eSpark-Backup/awad-shibli-wireless-sensor-network/README.md

# AwadShibli-WirelessSensorNetwork

Project Scope:
 
This project involves the end-to-end development of a wireless sensor network (WSN) using LoRa technology to monitor key environmental parameters such as temperature, humidity, and air quality. The system will include multiple distributed sensor nodes communicating wirelessly with a centralized base station, providing real-time data acquisition and visualization.
 
⸻
 
1. Research & Development (R&D) Deliverables
• 1.1 Technology Review Report:
• Detailed overview of LoRa communication protocol and its advantages for low-power, long-range applications.
• Summary of relevant sensors (temperature, humidity, air quality) and microcontrollers suitable for integration with LoRa modules.
• 1.2 Requirements Specification:
• Defined functional requirements including sampling rate, communication range, and accuracy.
• Non-functional requirements such as low power consumption, environmental robustness, and data integrity.
• 1.3 Component Selection Report:
• Justification for selected sensors, microcontrollers (e.g., STM32, ATmega), LoRa modules (e.g., SX1276), and power sources (battery, solar).
• Datasheets and comparison tables.
 
⸻
 
2. System Design Deliverables
• 2.1 System Architecture Diagram:
• Overview showing distributed sensor nodes, LoRa links, and the central LoRa gateway or base station.
• 2.2 Hardware Design Documents:
• Schematic diagrams and PCB layouts for sensor nodes and base station interface.
• BOM (Bill of Materials) with part numbers and sources.
• 2.3 Software Design Documents:
• Firmware architecture for sensor data acquisition and LoRa transmission.
• Base station software for packet reception, decoding, and data logging.
• Data structure and communication protocol definitions.
 
⸻
 
3. Prototype Development Deliverables
• 3.1 Functional Sensor Nodes (minimum 3 units):
• Each node equipped with LoRa transceiver, environmental sensors, and battery power.
• Integrated and tested for accurate sensing and reliable LoRa communication.
• 3.2 Base Station Implementation:
• Receives data via LoRa and displays/stores it locally.
• Optional GUI or command-line interface for monitoring.
• 3.3 Enclosure and Mounting Designs:
• Optional 3D-printed or off-the-shelf weatherproof housings for field deployment.
 
⸻
 
4. Testing and Validation Deliverables
• 4.1 Functional Verification:
• End-to-end validation of sensor readings, data transmission, and base station reception.
• 4.2 Range Testing:
• Measurement of maximum reliable communication range in both open and obstructed environments.
• 4.3 Data Integrity and Reliability Testing:
• Packet loss rate, latency, and error rate evaluation.
• 4.4 Sensor Calibration Report:
• Calibration results and comparison to commercial-grade instruments.
 
⸻
 
5. Final Documentation Deliverables
• 5.1 Technical Report:
• Comprehensive documentation of the entire system including R&D, design, implementation, and testing.
• 5.2 User Guide:
• Step-by-step instructions for deploying and operating the WSN system.
• 5.3 Source Code and Design Files:
• Fully commented source code for firmware and base station.
• All schematics, PCB files, and mechanical design files.
• 5.4 Project Presentation Slides:
• Visual summary for stakeholders, including objectives, system overview, results, and future improvements.
 
⸻
 
6. Optional Deliverables
• 6.1 Data Logging to Cloud Platform:
• Integration with platforms such as ThingSpeak or AWS IoT for remote monitoring and data analysis.
• 6.2 Power Optimization Report:
• Sleep modes, duty cycling, and solar charging implementation for extended deployment.
• 6.3 Scalable Network Design:
• Outline for expanding the node count or integrating additional environmental parameters.
