eSpark-Backup/awad-shibli-wireless-sensor-network/docs/Scheme/Project_Scheme_End-Device.pdf

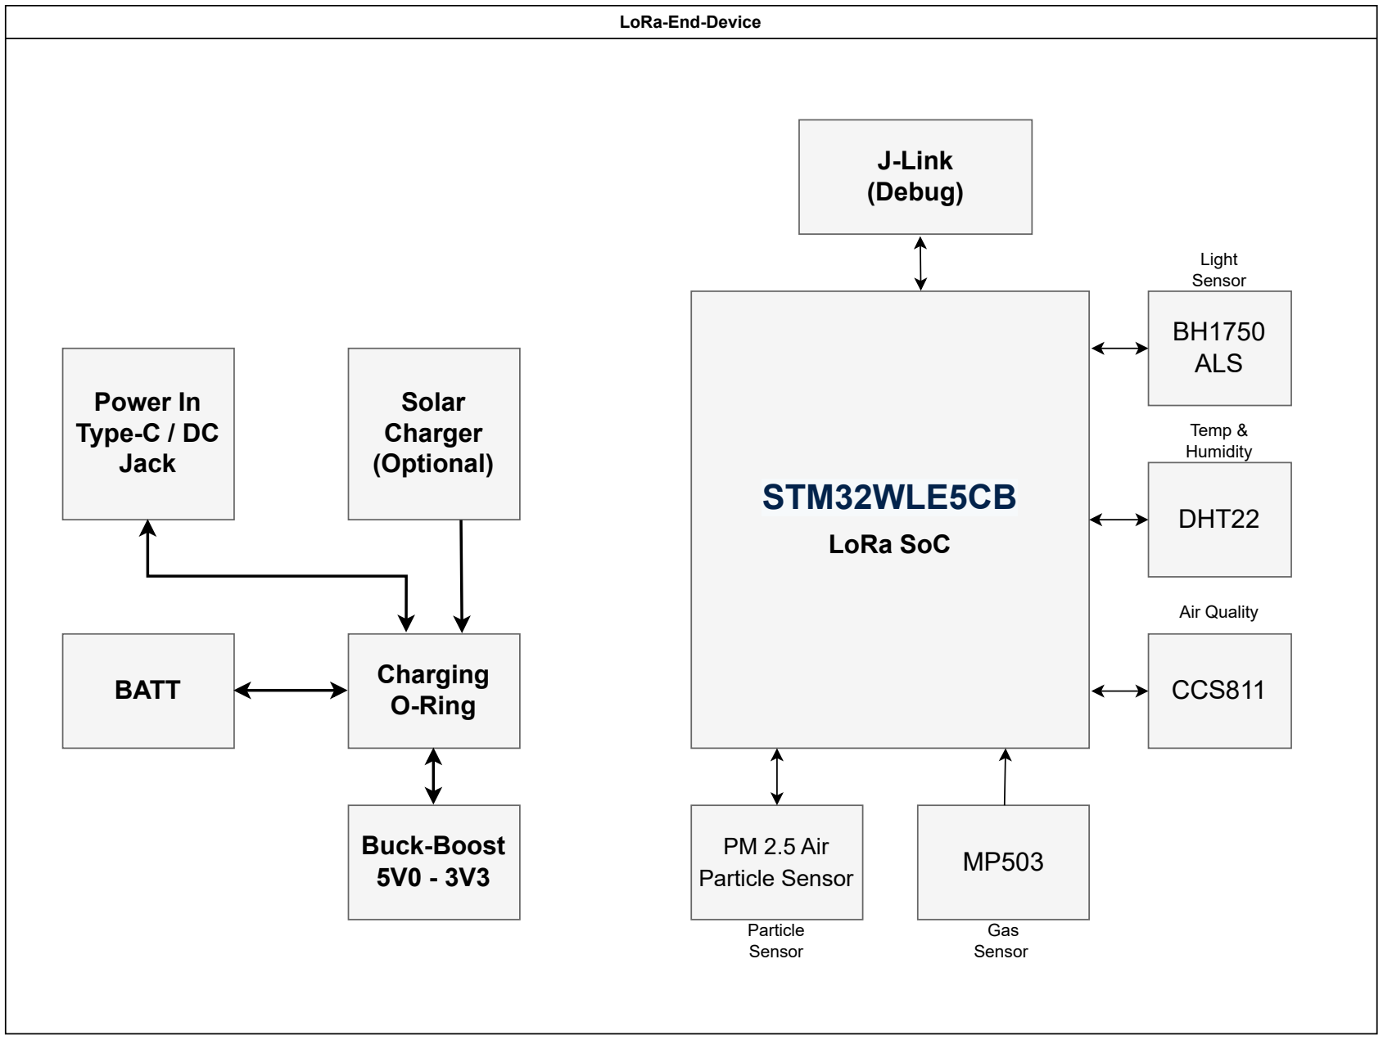
[picture p2: figure]
STM32WLE5CB; LoRa SoC; Buck-Boost 5V0 - 3V3; PM 2.5 Air Particle Sensor; J-Link (Debug); CCS811; Charging O-Ring BATT; DHT22; Power In Type-C / DC Jack; BH1750 ALS; Light Sensor; Temp & Humidity; Air Quality; Particle Sensor; Gas Sensor; Solar Charger (Optional); LoRa-End-Device
