eSpark-Backup/awad-shibli-wireless-sensor-network/Design-Files/End-Device-v1.0/Deliverables/_Renderings/2D_SecondLayer_View.png

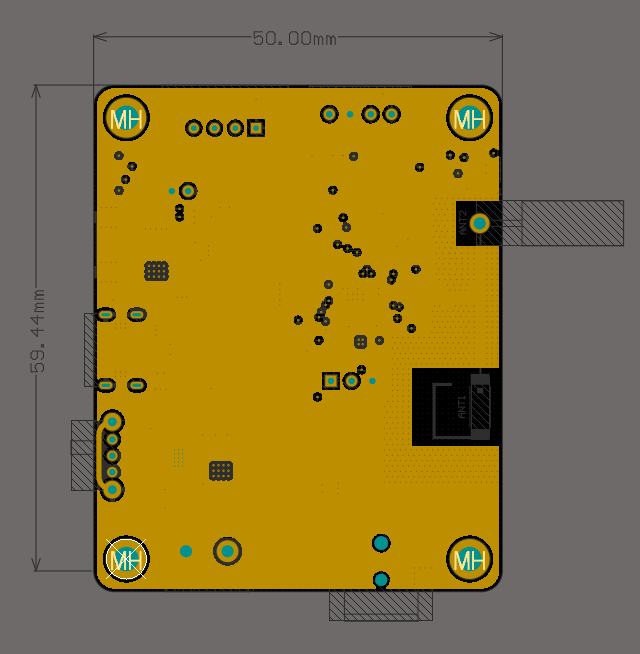
Design-Files/End-Device-v1.0/Deliverables/_Renderings/2D_SecondLayer_View.png
