eSpark-Backup/awad-shibli-wireless-sensor-network/Design-Files/Gateway-Device-v1.0/Deliverables/_Renderings/2D_ThirdLayer_View.png

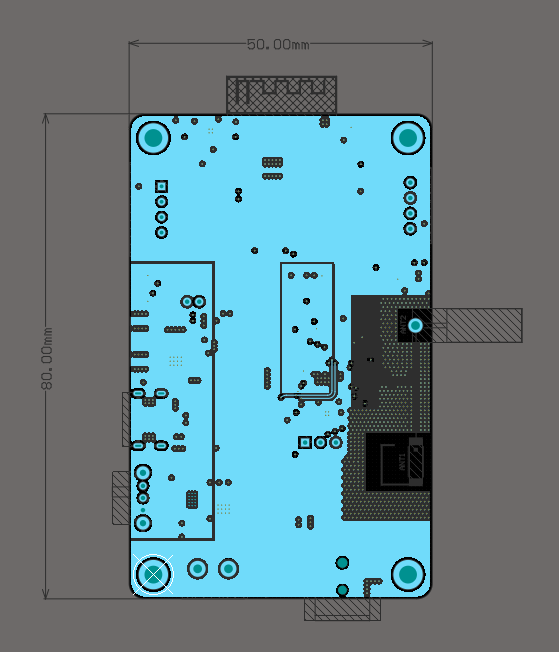
Design-Files/Gateway-Device-v1.0/Deliverables/_Renderings/2D_ThirdLayer_View.png
