eSpark-Backup/awad-shibli-wireless-sensor-network/Design-Files/End-Device-v1.0/Deliverables/BOM/Client BOM of End-Device-v1.0.xlsx

# | Item Type | Designator | Description | Footprint | Manufacturer Part Number | Manufacturer | Value | Quantity | Remarks
1 | RF Antennas | ANT1 | RF ANT 915MHZ CHIP SOLDER SMD | Custom | 0915AT43A0026001E | Johanson | - | 1
2 | Antenna | ANT2 | 1.8 Helical Antenna Vertical 915MHz 50W Antennas ROHS | Custom | VG915SNX17-5W2 | Vollgo | - | 1
3 | Capacitors | C1, C3, C12 | CAP CER 10UF 25V X7R 0805 | Cap-0805 | GRM21BZ71E106KE15L | Murata | 10uF | 3
4 | Capacitors | C2, C4, C11, C17, C21, C22, C25, C28, C40, C41, C47, C48, C49, C50 | CAP CER 0.1UF 25V X7R 0402 | Cap-0402 | CC0402KRX7R8BB104 | Yageo | 0.1uF | 14
5 | Capacitor | C5, C10 | CAP CER 4700PF 1KV X7R 1206 | Cap-1206 | CC1206KKX7RCBB472 | Yageo | 4.7nF | 2
6 | Capacitor | C6 | CAP CER 22UF 10V X7R 0805 | Cap-0805 | GRM21BZ71A226ME15L | Murata | 22uF | 1
7 | Capacitor | C7, C8, C9 | CAP CER 10UF 10V X7R 0603 | Cap-0603 | GRM188Z71A106KA73D | Murata | 10uF | 3
8 | Capacitor | C16, C24, C27 | CAP CER 4.7UF 16V X5R 0402 | Cap-0402 | CL05A475MO5NUNC | Samsung | 4.7uF | 3
9 | Capacitors | C18, C23, C33, C34 | CAP CER 33PF 50V C0G/NP0 0402 | Cap-0402 | GJM1555C1H330GB01D | Murata | 33pF | 4
10 | Capacitor | C19, C20 | CAP CER 6.8PF 50V C0G/NPO 0402 | Cap-0402 | CC0402CRNPO9BN6R8 | Yageo | 6.8pF | 2
11 | Capacitors | C29 | CAP CER 0.47UF 50V X5R 0402 | Cap-0402 | GRM155R61H474KE11D | Murata | 470nF | 1
12 | Capacitor | C30 | CAP CER 0.047UF 50V X7R 0402 | Cap-0402 | CC0402KRX7R9BB473 | Yageo | 47nF | 1
13 | Capacitors | C31 | CAP CER 68PF 50V C0G/NPO 0402 | Cap-0402 | CC0402FRNPO9BN680 | Yageo | 68pF | 1
14 | Capacitor | C32, C38 | CAP CER 2.2PF 50V C0G/NP0 0402 | Cap-0402 | GRM1555C1H2R2BA01D | Murata | 2.2pF | 2
15 | Capacitors | C35 | CAP CER 10000PF 50V X7R 0402 | Cap-0402 | GRM155R71H103KA88D | Murata | 10nF | 1
16 | Capacitors | C36 | CAP CER 0.7PF 50V C0G/NP0 0402 | IND-0402 | GJM1555C1HR70BB01D | Murata | 0.7pF | 1
17 | Capacitors | C37 | CAP CER 7.5PF 50V C0G/NP0 0402 | Cap-0402 | GJM1555C1H7R5BB01D | Murata | 7.5pF | 1
18 | Capacitors | C39 | CAP CER 4PF 50V C0G/NP0 0402 | Cap-0402 | GJM1555C1H4R0BB01D | Murata | 4pF | 1
19 | Capacitors | C42 | CAP CER 47PF 50V C0G/NP0 0402 | Cap-0402 | GCM1555C1H470FA16D | Murata | 47pF | 1
20 | Capacitor | C43 | CAP CER 10PF 50V C0G/NP0 0402 | Cap-0402 | GRM1555C1H100JA01D | Murata | 10pF | 1
21 | Capacitors | C46 | CAP CER 4.3PF 50V C0G/NP0 0402 | Cap-0402 | GJM1555C1H4R3BB01D | Murata | 4.3pF | 1
22 | TVS Diodes | D1 | 9.5V 400W 7.5V 5V WSON-6(2x2) ESD and Surge Protection (TVS/ESD) ROHS | WSON-6(2x2) | TVS0500DRVR | Texas Instruments | - | 1
23 | Diode | D2 | Independent 5W 18V SMB Zener Diodes ROHS | SMB_ | SMBJ5355B-MS | MSKSEMI | - | 1
24 | ESD Diode | D3 | 1 Surface Mount WSON-6(2x2) Surge Protection Devices (SPDs) ROHS | WSON-6(2x2) | TVS1800DRVR | Texas Instruments | - | 1
25 | Diode | D4, D5, D6 | 40V 500mV@2A 2A SMA(DO-214AC) Schottky Barrier Diodes (SBD) ROHS | SMA | SS24A | Guangdong Hottech | - | 3
26 | Diode | D7 | TVS DIODE 3VWM ST0201 | Diode-0201 | ESDALC6V1-1U2 | STMicroelectronics | - | 1
27 | Fuse | F1 | 24V 750mA 100A 1.5A 1210 Resettable Fuses ROHS | FUSE-1210 | 1210L075/24PR | Littlefuse | - | 1
28 | Ferrite Bead | FB1 | 500mΩ ±25% 600Ω@100MHz 0603 Ferrite Beads ROHS | IND-0603 (1608 Metric) | FCM1608KF-601T03 | Tai Tech | - | 1
29 | Ferrite Beads | FB2 | FERRITE BEAD 1 KOHM 0402 1LN | IND-0402 | BLM15HG102SN1D | Murata | - | 1
30 | Connector | J1 | Receptacle USB - Type C 6 - USB Connectors ROHS | Custom | Type-C-31-M-17 | Koren Hroparts Elec | - | 1
31 | Connectors | J2 | CONN HEADER SMD R/A 2POS 2MM | Custom | S2B-PH-SM4-TB(LF)(SN) | JST | - | 1
32 | Terminal Block | J3 | 1x2P 18A -40℃~+105℃ 250V Green 12~30 Straight 5.08mm 2.5 1 2 Plugin,P=5.08mm Screw terminal ROHS | Custom | DB128L-5.08-2P-GN-S | DORABO | - | 1
33 | DC Jack | J4 | Surface Mount DC Power Receptacle -20℃~+70℃ 2mm 6.4mm 2A 30V SMD AC/DC Power Connectors ROHS | Custom | DC-050-B200 | XUNPU | - | 1
34 | Male Header | J5 | Gold 250V 3A Straight Square Pins 2.5mm 3P 260℃ 6mm -40℃~+105℃ 3mm 2.54mm Plugin Black Brass 1x3P Plugin,P=2.54mm Pin Headers ROHS | HDR1X3_ | X6511WV-03H-C60D30 | XKB | - | 1
35 | Male Header | J7 | Gold 250V 1A Brick nogging Square Pins 1mm 10P 260℃ 4mm -40℃~+105℃ 1.27mm 双排 Black Brass 2x5P SMD,P=1.27mm Pin Headers ROHS | Custom | X1321WVS-2x05J-C40D53 | XKB Connectivity | - | 1
36 | Inductor | L1 | FIXED IND 1UH 3.2A 0.042OHM SMD | IND-1008 (2520 Metric) | DFE252012P-1R0M=P2 | Murata | 1uH | 1
37 | Fixed Inductors | L2 | FIXED IND 15UH 250MA 950MOHM SMD | IND-0805 | MLZ2012M150WT000 | TDK | 15uH | 1
38 | Fixed Inductors | L3 | FIXED IND 47NH 210MA 1.08OHM SMD | IND-0402 | LQW15AN47NG00D | Murata | 47nH | 1
39 | Fixed Inductors | L4 | FIXED IND 3.3NH 900MA 0.04OHM SM | IND-0402 | LQW15AN3N3D10D | Murata | 3.3nH | 1
40 | Fixed Inductors | L5 | FIXED IND 8.2NH 540MA 0.14OHM SM | IND-0402 | LQW15AN8N2G00D | Murata | 8.2nH | 1
41 | Fixed Inductors | L6 | FIXED IND 9.1NH 1.4A 0.08OHM SMD | IND-0402 | LQW15AN9N1G8ZD | Murata | 9.1nH | 1
42 | LED | LED1 | RED LED 0603 Light Emitting Diodes | LED-0603 | NCD0603R3 | Foshan NationStar Optoelectronics | - | 1
43 | LED | LED2 | Emerald 0603 Light Emitting Diodes (LED) ROHS | LED-0603 | NCD0603G2 | Foshan NationStar Optoelectronics | - | 1
44 | NTC Thermistors | NTC1 | 10kΩ 50mW ±1% NTC Thermistors ROHS | Custom | MF51B 103F3435 | Nanjing Shiheng Elec | 10K | 1
45 | MOSFET | Q1 | MOSFET P-CH 30V 4.3A SOT23-3 | SOT-23 | AOSS21311C | Alpha & Omega Semiconductor | - | 1
46 | Mosfet | Q2 | Trans Mosfet P-ch 30V 4A 3-PIN SOT-23 T/r | SOT-23 | AO3401A | Alpha & Omega Semiconductor | - | 1
47 | Resistor | R1, R3 | RES 5.1K OHM 1% 1/16W 0402 | Res-0402 | RC0402FR-075K1L | Yageo | 5.1K | 2
48 | Resistors | R2, R4, R36 | RES 220 OHM 1% 1/16W 0402 | Res-0402 | RC0402FR-07220RL | Yageo | 220R | 3
49 | Resistor | R5 | RES SMD 21.5KOHM 0.1% 1/16W 0402 | Res-0402 | RT0402BRD0721K5L | Yageo | 21.5K | 1
50 | Resistor | R6, R9 | RES SMD 1M OHM 1% 1/10W 0603 | Res-0603 | RC0603FR-071ML | Yageo | 1M | 2
51 | Resistor | R7 | RES SMD 6.98KOHM 0.1% 1/16W 0402 | Res-0402 | RT0402BRD076K98L | Yageo | 6.98K | 1
52 | Resistors | R8 | RES SMD 649 OHM 0.1% 1/16W 0402 | Res-0402 | RT0402BRD07649RL | Yageo | 649R | 1
53 | Resistor | R10, R44 | RES SMD 10 OHM 1% 1/10W 0603 | Res-0603 | RC0603FR-0710RL | Yageo | 10R | 2
54 | Resistor | R11 | RES 47K OHM 1% 1/16W 0402 | Res-0402 | RC0402FR-0747KL | Yageo | 47K | 1
55 | Resistors | R16, R17, R24, R29, R34, R35, R38, R39 | RES 0 OHM JUMPER 1/16W 0402 | Res-0402 | RC0402FR-070RL | Yageo | 0R | 8
56 | Resistor | R25 | RES 10K OHM 1% 1/16W 0402 | Res-0402 | RC0402FR-0710KL | Yageo | 10K | 1
57 | Resistor | R27, R28 | RES 0 OHM JUMPER 1/8W 0805 | Res-0805 | RC0805FR-070RL | Yageo | 0R | 2
58 | Resistor | R31 | RES 1K OHM 1% 1/20W 0201 | Res-0201 | RC0201FR-071KP | Yageo | 1K | 1
59 | Resistor | R32, R33, R41, R42 | RES 4.7K OHM 1% 1/16W 0402 | Res-0402 | RC0402FR-074K7L | Yageo | 4.7K | 4
60 | Resistor | R40, R43 | RES 1K OHM 1% 1/16W 0402 | Res-0402 | RC0402FR-071KL | Yageo | 1K | 2
61 | Slide Switch | SW1 | Lying 1A SPDT 9.6mm 8.6mm 24V 3.6mm Black PCPin 10000 Rectangular columnar -25℃~+70℃ Plugin Slide Switches ROHS | Custom | SK-12D29-G060 | G-Switch | - | 1
62 | Switch | SW4 | SWITCH TACTILE SPST-NO 0.05A 12V | Custom | B3U-1000P | Omron | - | 1
63 | IC | U1 | IC BATT CHG LI-ION 1CELL 10WSON | 10-WSON (3x2) | BQ24210DQCR | Texas Instruments | - | 1
64 | IC | U2 | IC REG BUCK BST 3.3V 3.5A 14VSON | 14-VSON (4x3) | TPS63021DSJR | Texas Instruments | - | 1
65 | IC | U3 | IC RF TXRX+MCU ISM<1GHZ 48UFQFPN | 48-UFQFPN(7x7) | STM32WLE5CBU6 | STMicroelectronics | - | 1
66 | IC | U5 | SENSOR OPT 560NM AMBIENT 6WSOF | 6-WSOF | BH1750FVI-TR | Rohm | - | 1
67 | Sensor | U6 | SIP-4 Temperature and Humidity Sensor ROHS | Custom | AM2302 | Aosong (Guangzhou) Elec | - | 1
68 | Sensor | U7 | SIP-4 Gas Sensors ROHS | Custom | AGS02MA | Aosong (Guangzhou) Elec | - | 1
69 | Crystal | X1 | CRYSTAL 32.7680KHZ 6PF SMD | Custom | NX3215SA-32.768K-STD-MUA-14 | NDK | 32.7680KHZ | 1
70 | Oscillators | X2 | XTAL OSC TCXO 32.0000MHZ CLPSNW | SMD2520-4P | ECS-TXO-25CSMV-320-DY-TR | ECS International | 32MHz | 1
71 | Crystal | X3 | CRYSTAL 32.0000MHZ 8PF SMD | SMD2520-4P | ECS-320-8-36B-CKY-TR | ECS International | 32MHz | 1
72 | Peripheral | Battery | 804050 2000mAh Battery 3.7V Li-Polymer Lithium Ion Batteries for Massager Medical Equipment Car Air Filter Loudspeaker | Custom | - | - | - | 1 | Aliexpress (https://vi.aliexpress.com/item/1005009196364640.html)
