eSpark-Backup/awad-shibli-wireless-sensor-network/Design-Files/End-Device-v1.0/Deliverables/_Supporting Files/End-Device-v1.0.step

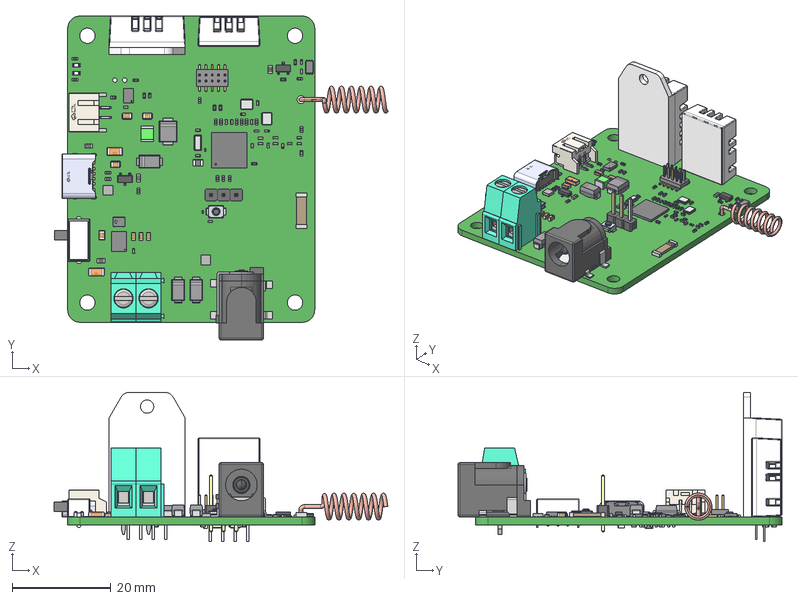
[picture p19: CAD file, 2025-07-15]
Design-Files/End-Device-v1.0/Deliverables/_Supporting Files/End-Device-v1.0.step
67.5 x 65.5 x 30.2 mm
User Library-Crystal NDK NX2520SA series x 2
User Library-RES_1005-0402 x 31
User Library-d0402h025 x 6
TPS7A2633DRVR x 2
User Library-DO-214AA SMB
User Library-Capacitor 0402 x 36
User Library-NDK_NX3215SA
UFQFPN-48_7X7X0P55MM
TPS63020DSJR--3DModel-STEP-1
User Library-OMRON B3U1000P
G-Switch SK-12D29-G060
User Library-RESC1608X05N x 4
User Library-0201(0603M) Res
User Library-CR2012-0805 x 2
CircuitWorks-SOT-23 x 2
User Library-LED SMD0603 x 2
VLS252012HBX-100M
User Library-RM127_10pin_Header
User Library-Header_Male_3Pin_PinArray
User Library-Header_Male_3Pin_BodyArray
DC-050-B200
SOLID.step
Lötende x 2
base
term1
term2
User Library-DO-214AC SMA x 3
User Library-0805 SMD Capacitor x 4
User Library-1206 SMD Capacitor x 2
User Library-CAPC1608X09 x 3
