eSpark-Backup/awad-shibli-wireless-sensor-network/(list of files, cad)

Other CAD files:
Design-Files/End-Device-v1.0/Deliverables/_Supporting Files/End-Device-v1.0..DXF
Design-Files/End-Device-v1.0/Deliverables/_Supporting Files/End-Device-v1.0.DWG
Design-Files/Gateway-Device-v1.0/Deliverables/_Supporting Files/Gateway-Device-v1.0..DWG
