eSpark-Backup/awad-shibli-wireless-sensor-network/Design-Files/End-Device-v1.0/Schematic/End-Device-v1.0.pdf

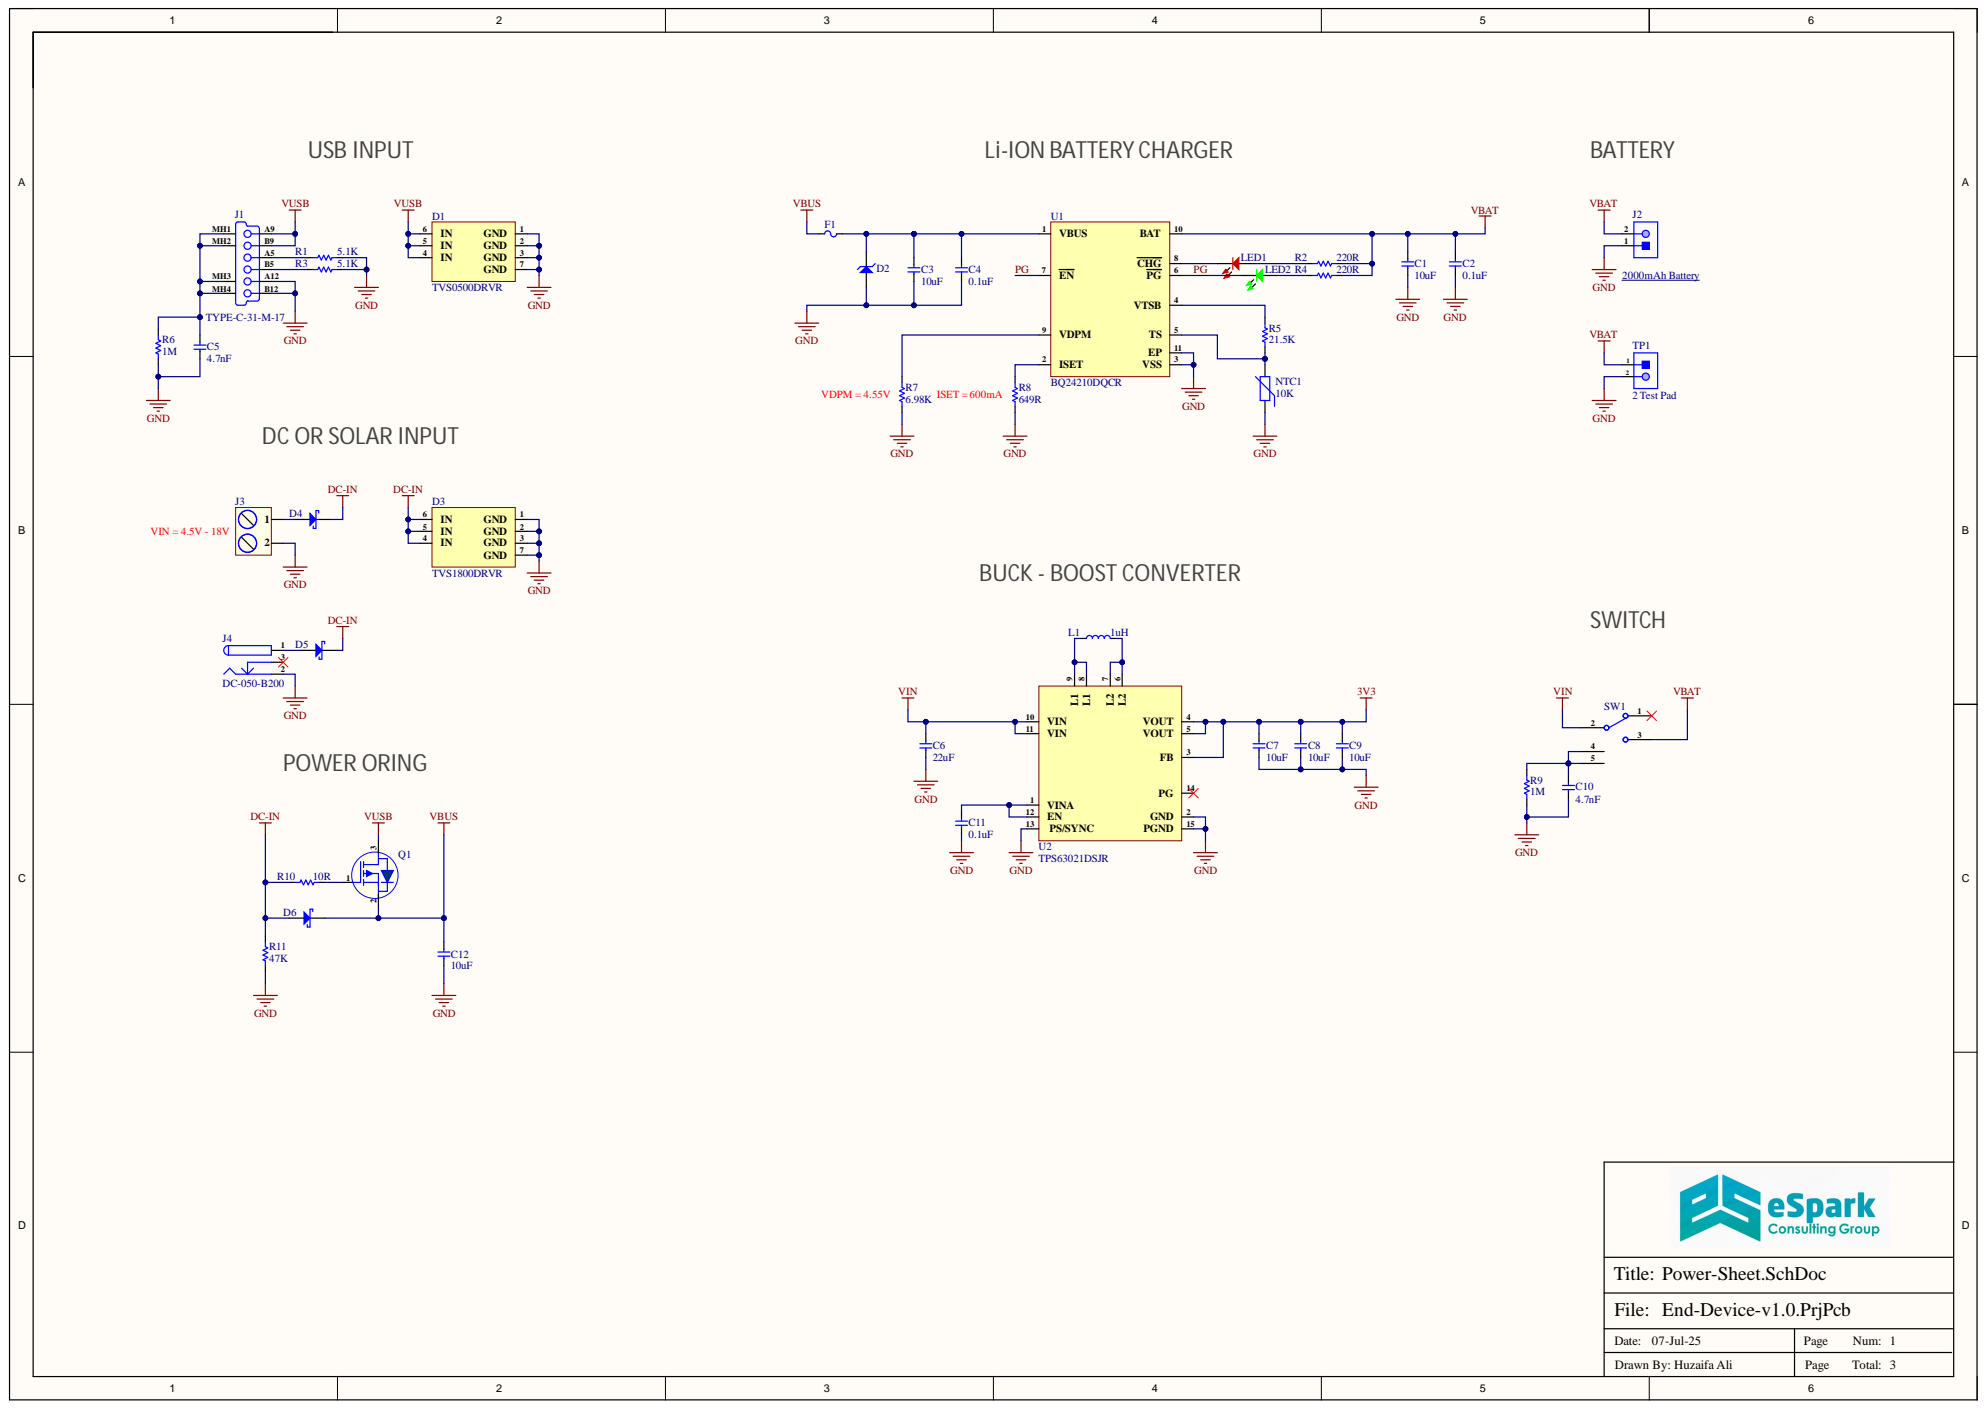
[picture p24: page 1]

Date : 0 7-Jul-2 5 | P a g e Nu m : 13

Drawn By: Hu z aifa Ali | P a g e T ota l :

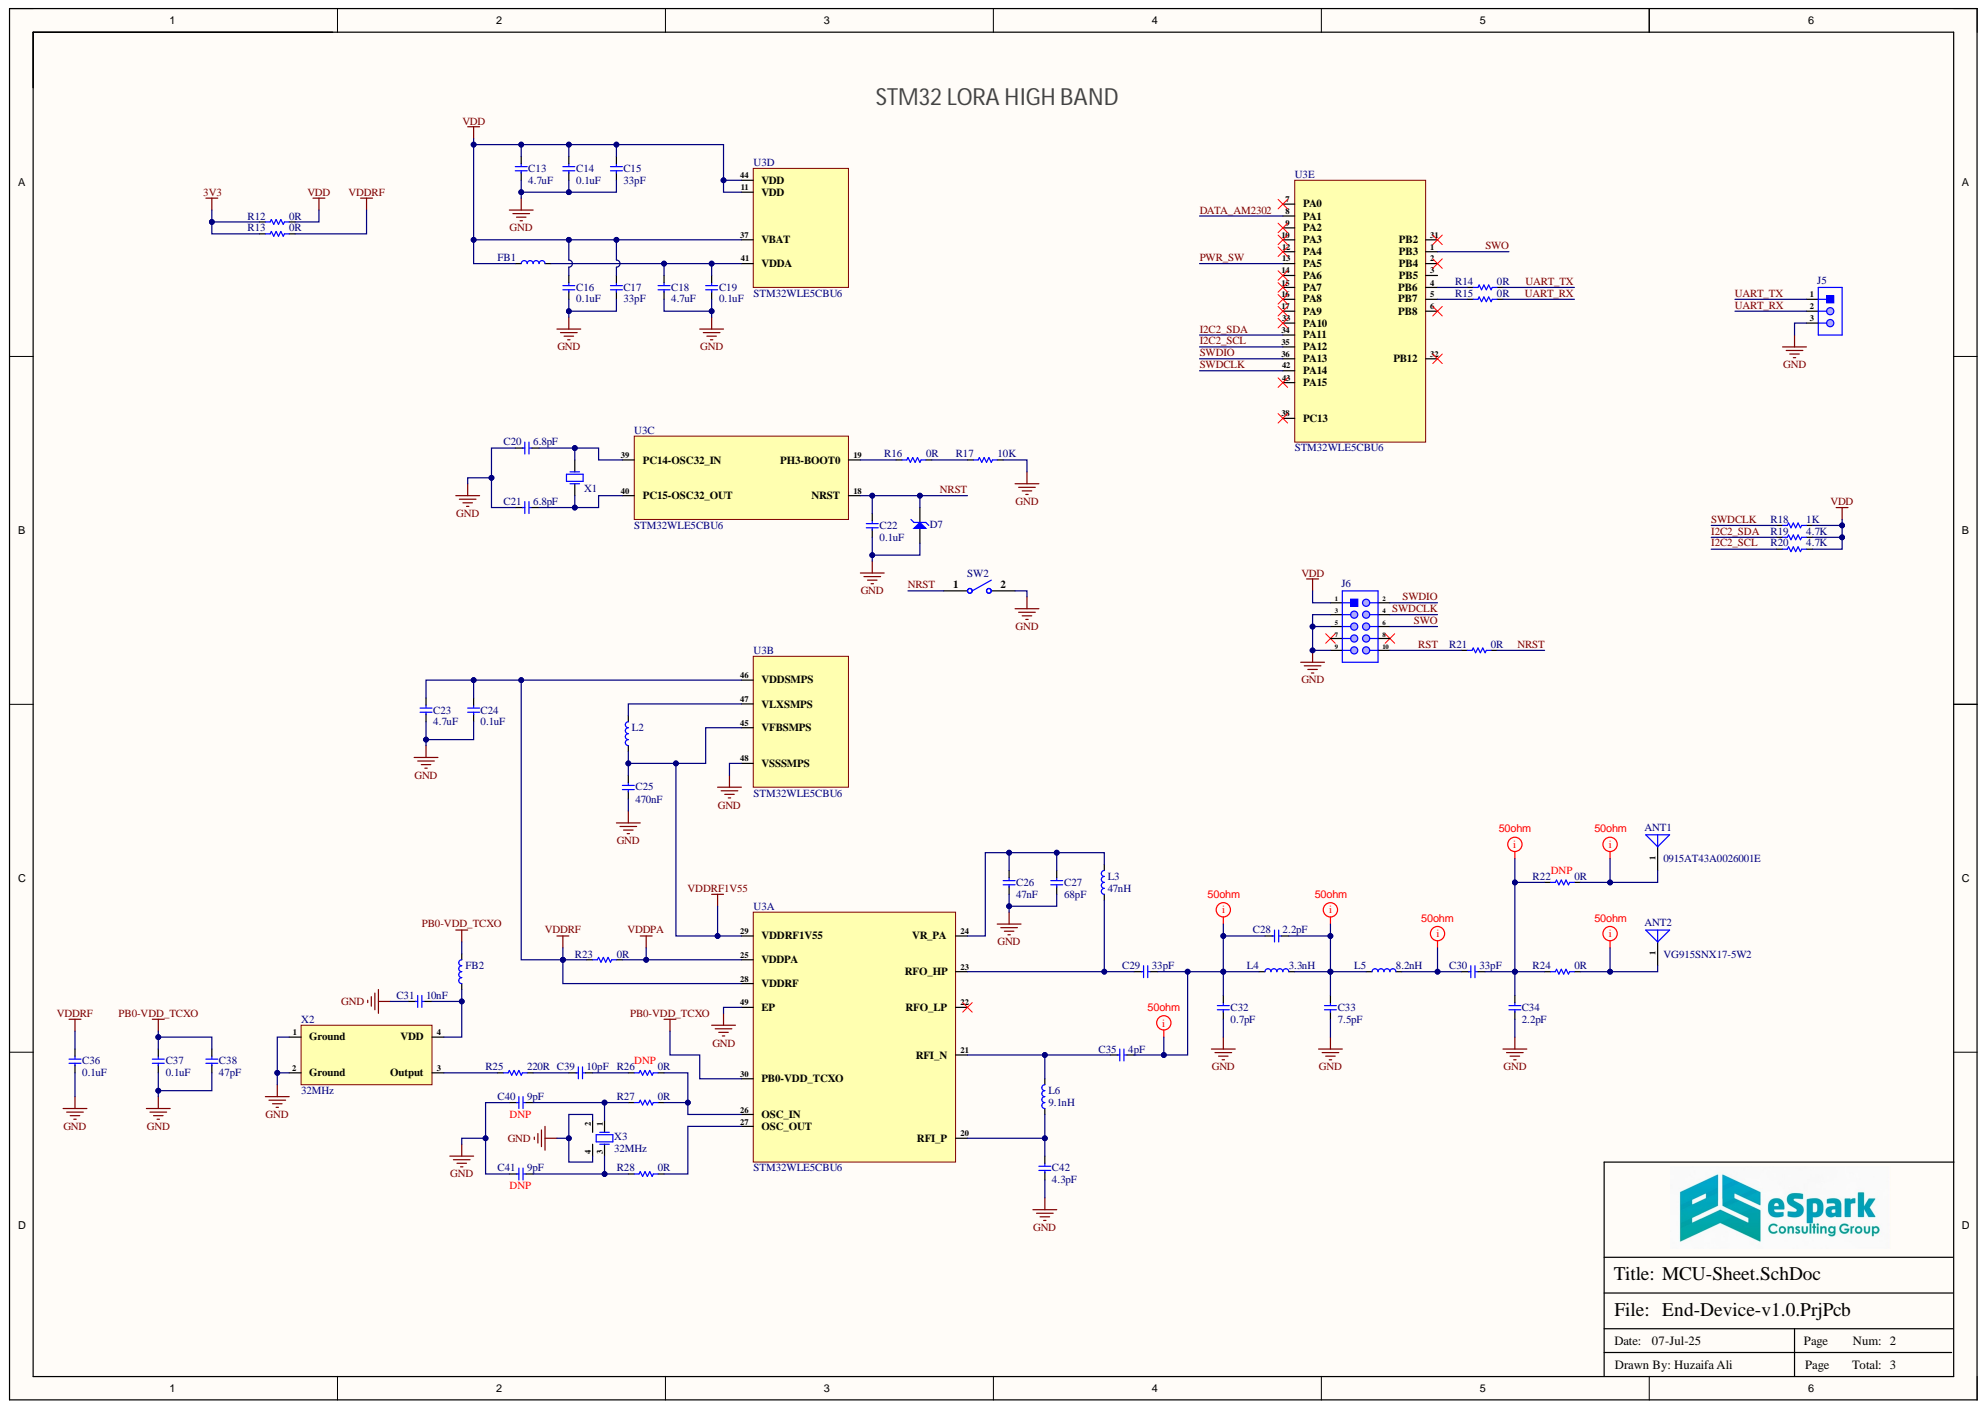
[picture p25: page 2]

Date: 07-Jul-25 | Page Num: 2

Drawn By: Huzaifa Ali | Page Total: 3

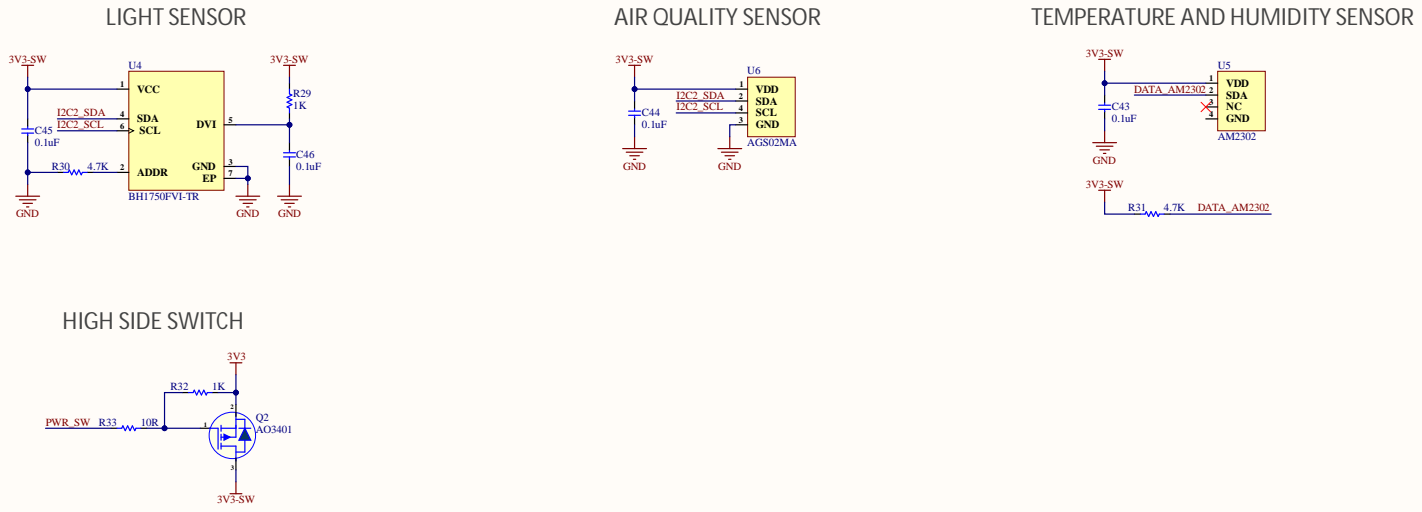
[picture p26: page 3]

Date : 0 7-Jul-2 5 | P a g e Nu m : 33

Drawn By: Hu z aifa Ali | P a g e T ota l :
