eSpark-Backup/awad-shibli-wireless-sensor-network/Design-Files/End-Device-v1.0/Deliverables/_Schematics/End-Device-v1.0.pdf

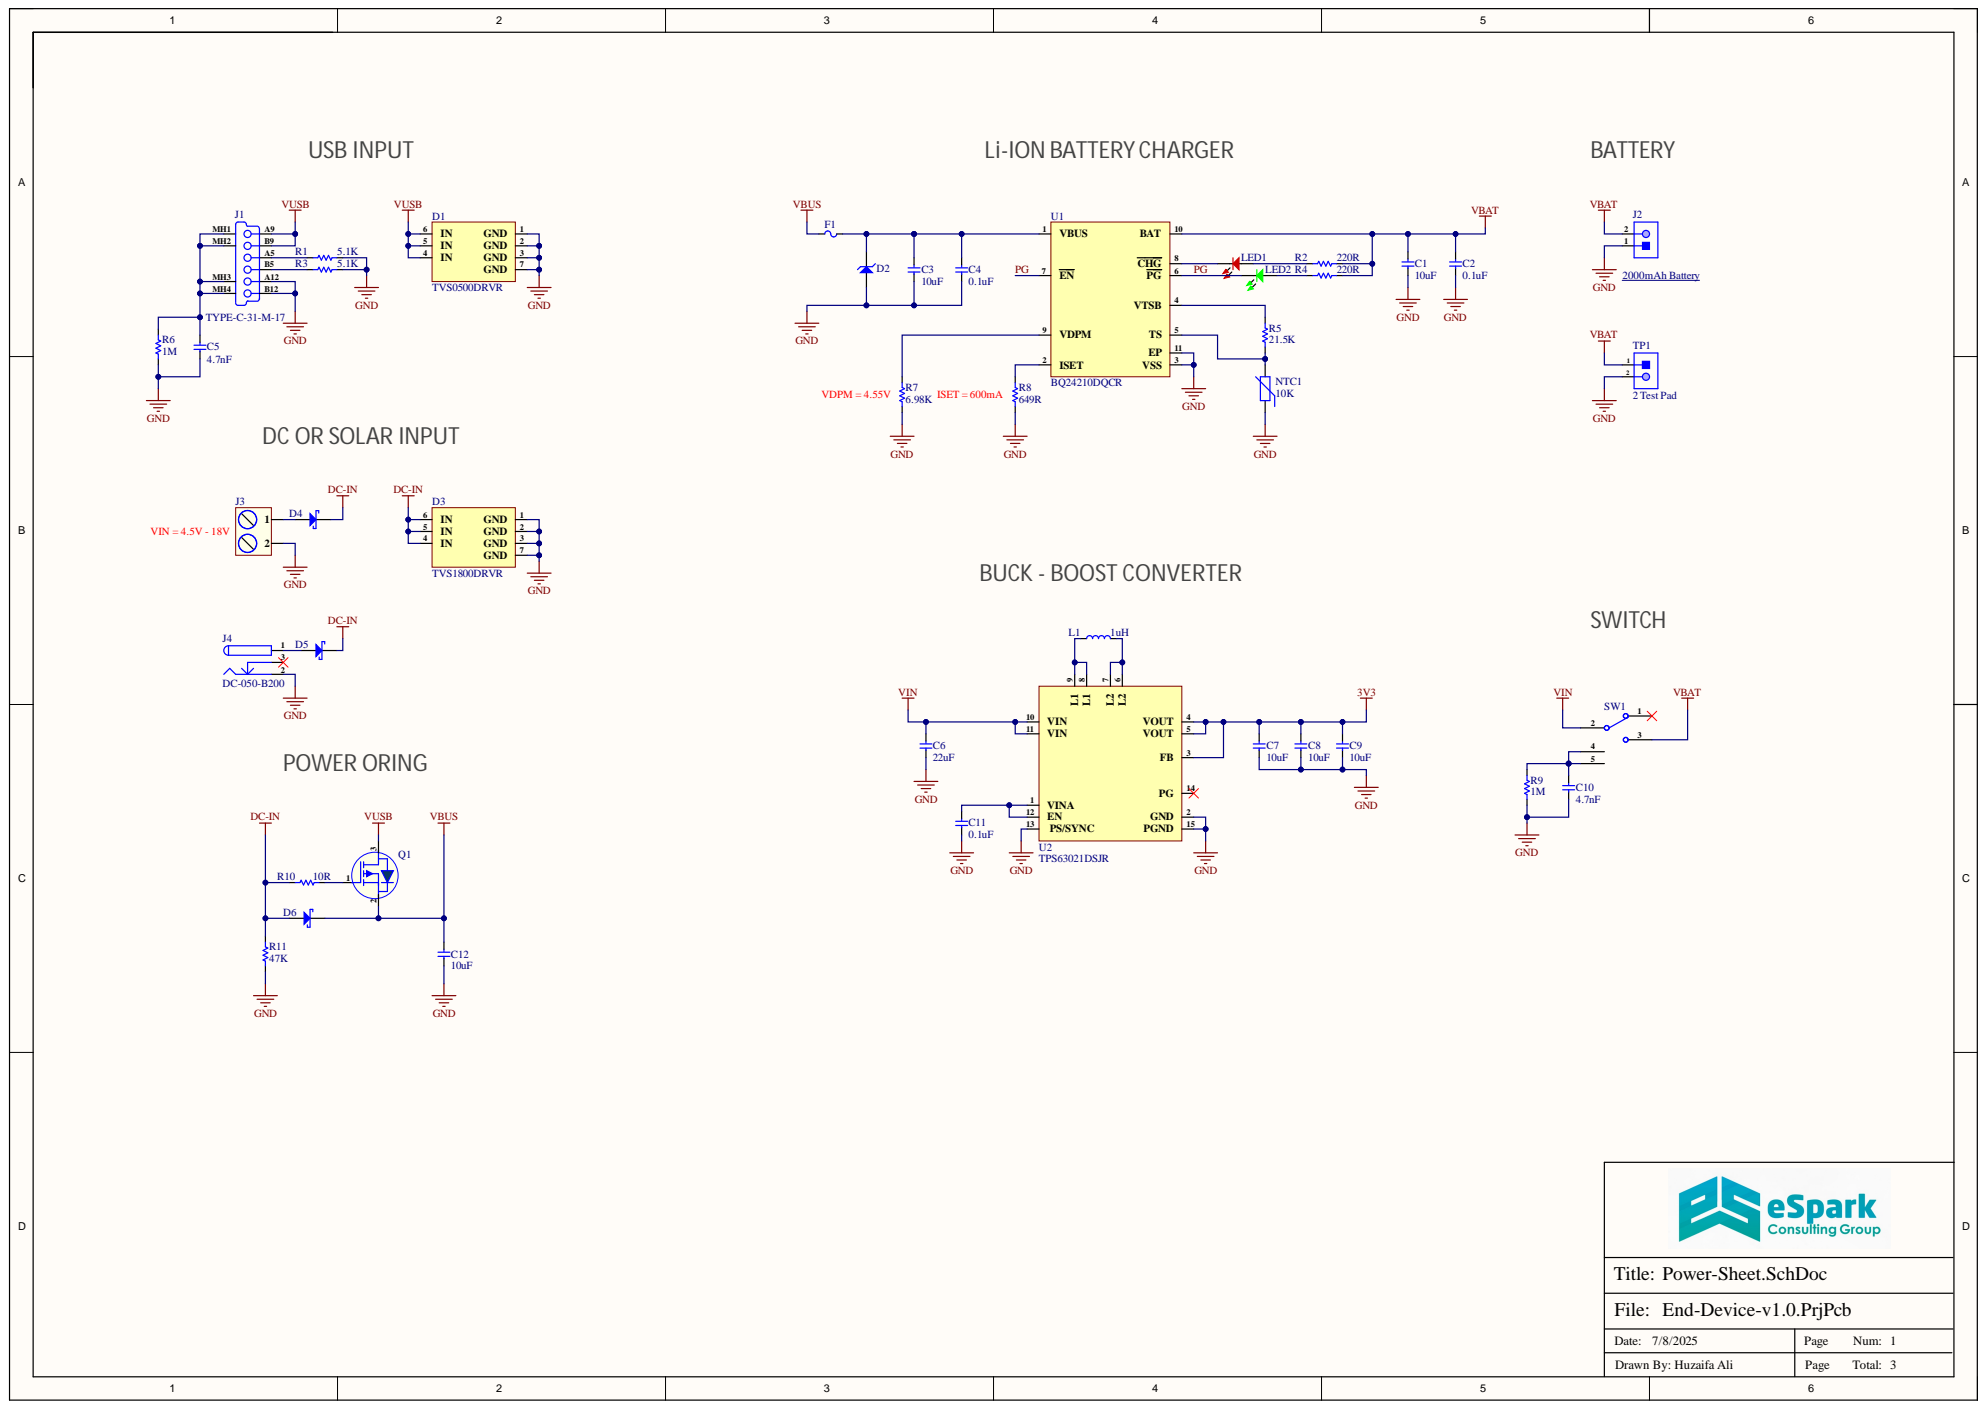
[picture p31: page 1]

Date : 7/8/2 0 2 5 | P a g e Nu m : 13

Drawn By: Hu z aifa Ali | P a g e T ota l :

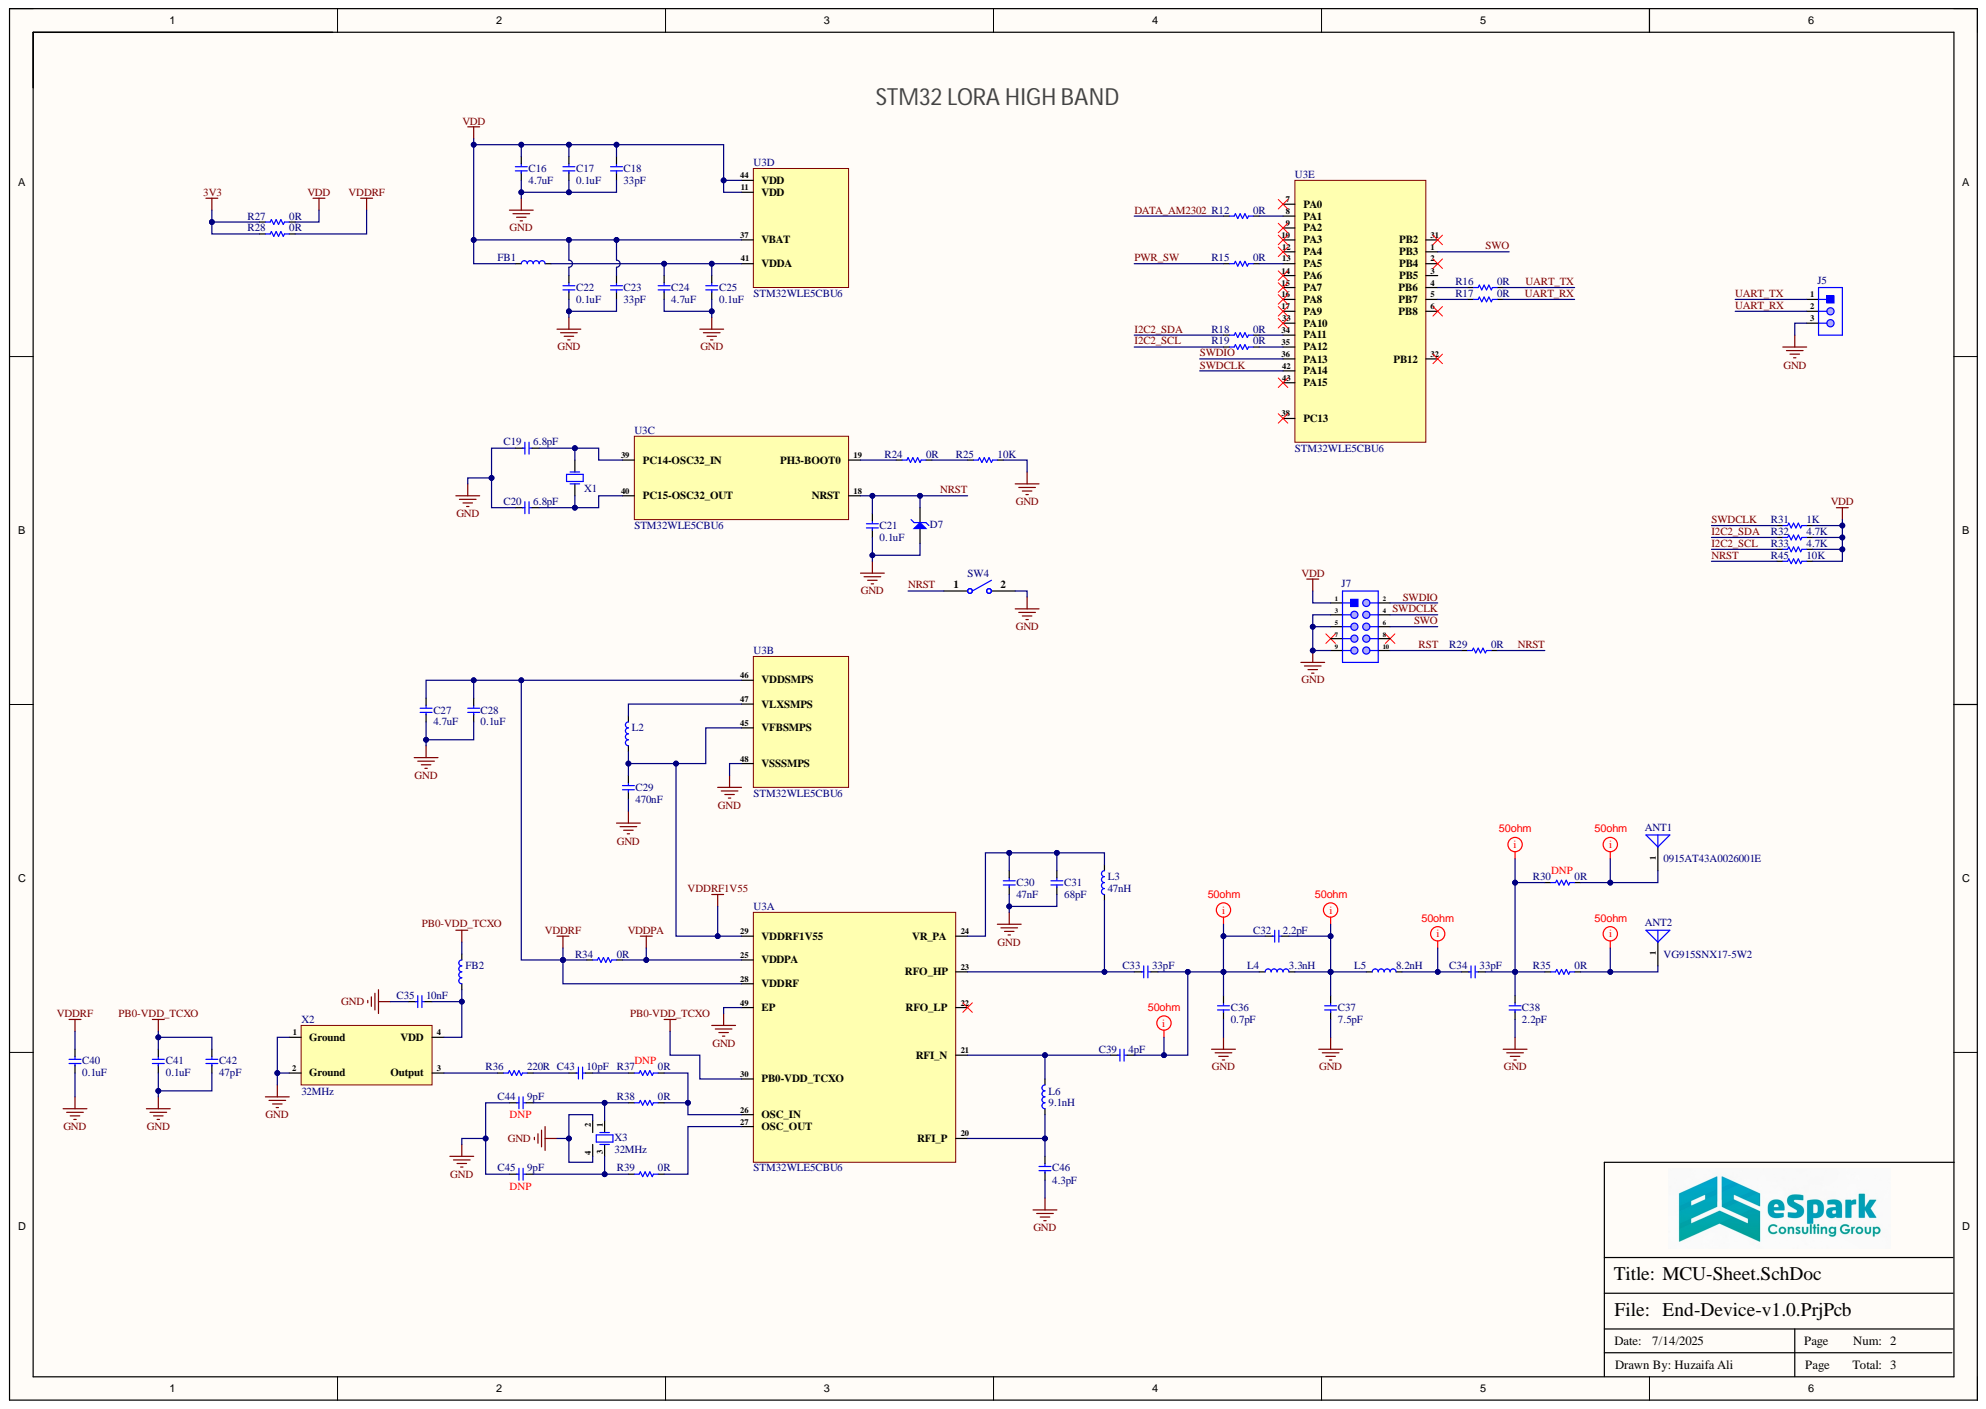
[picture p32: page 2]

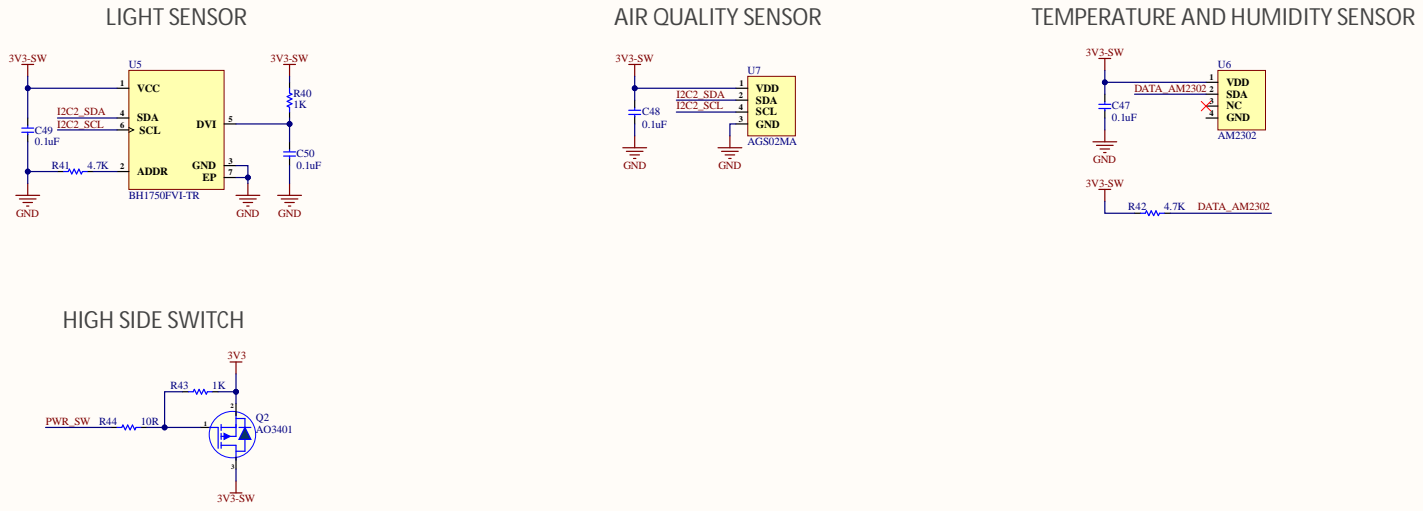
[picture p33: page 3]

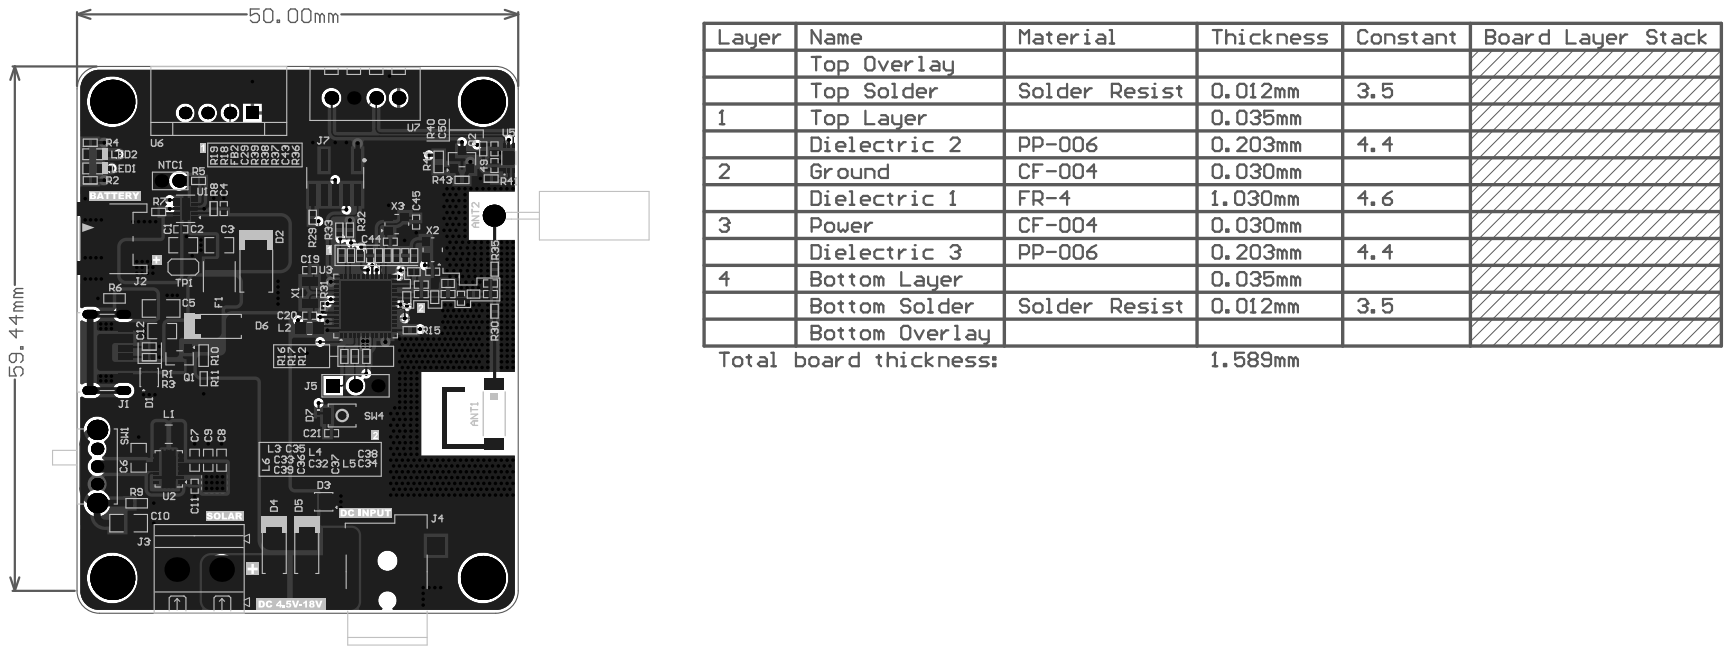
[picture p34: page 4]
