eSpark-Backup/awad-shibli-wireless-sensor-network/Design-Files/Gateway-Device-v1.0/Deliverables/_Schematics/Gateway-Device-v1.0.pdf

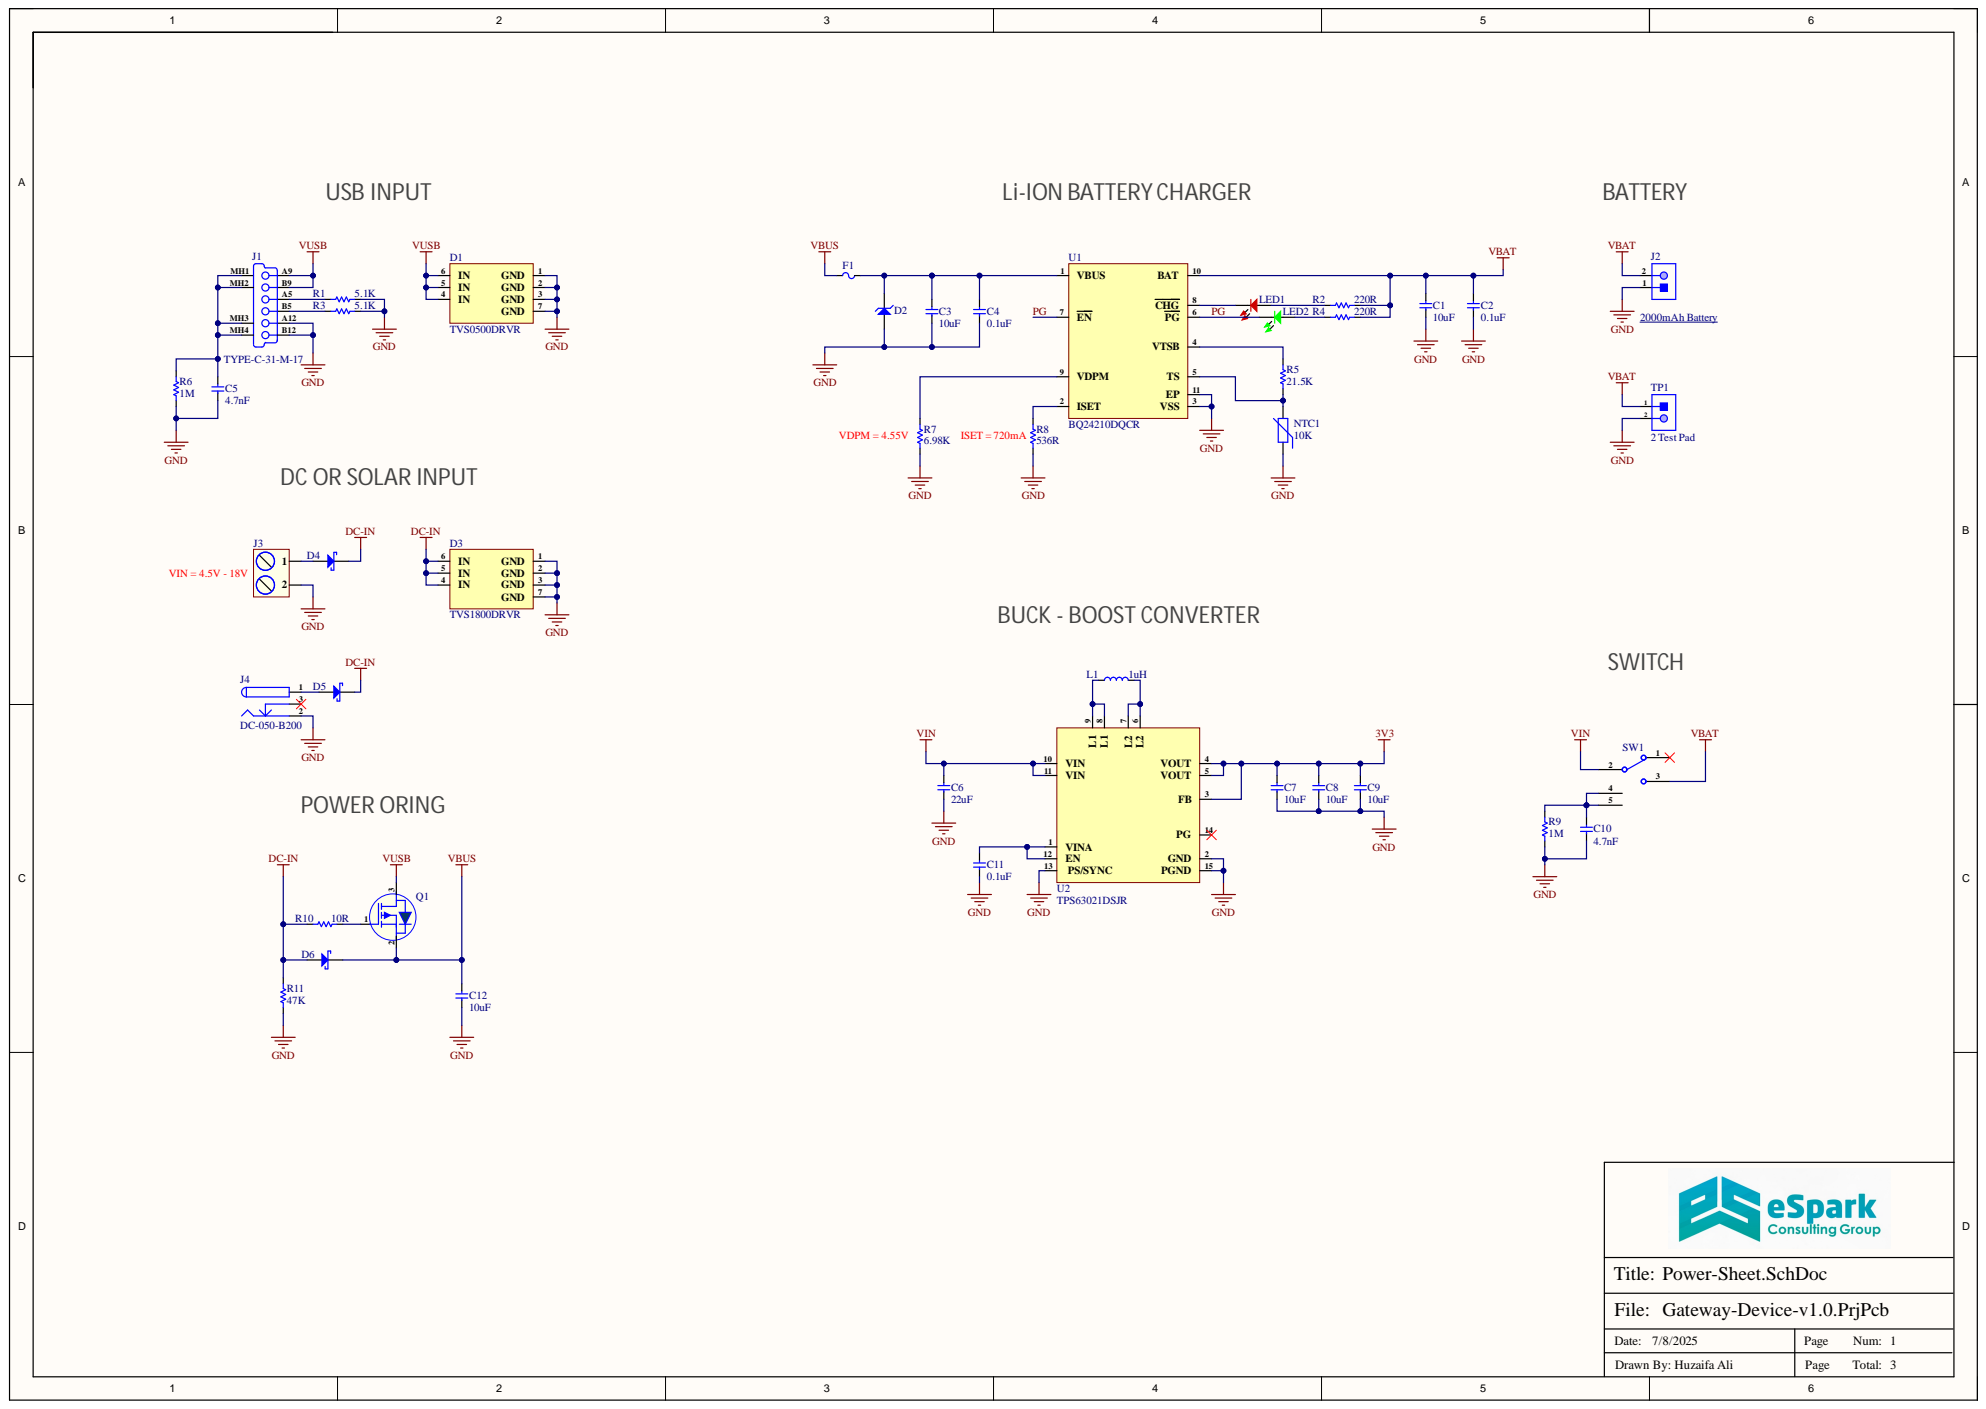
[picture p39: page 1]

Date : 7/8/2 0 2 5 | P a g e Nu m : 13

Drawn By: Hu z aifa Ali | P a g e T ota l :

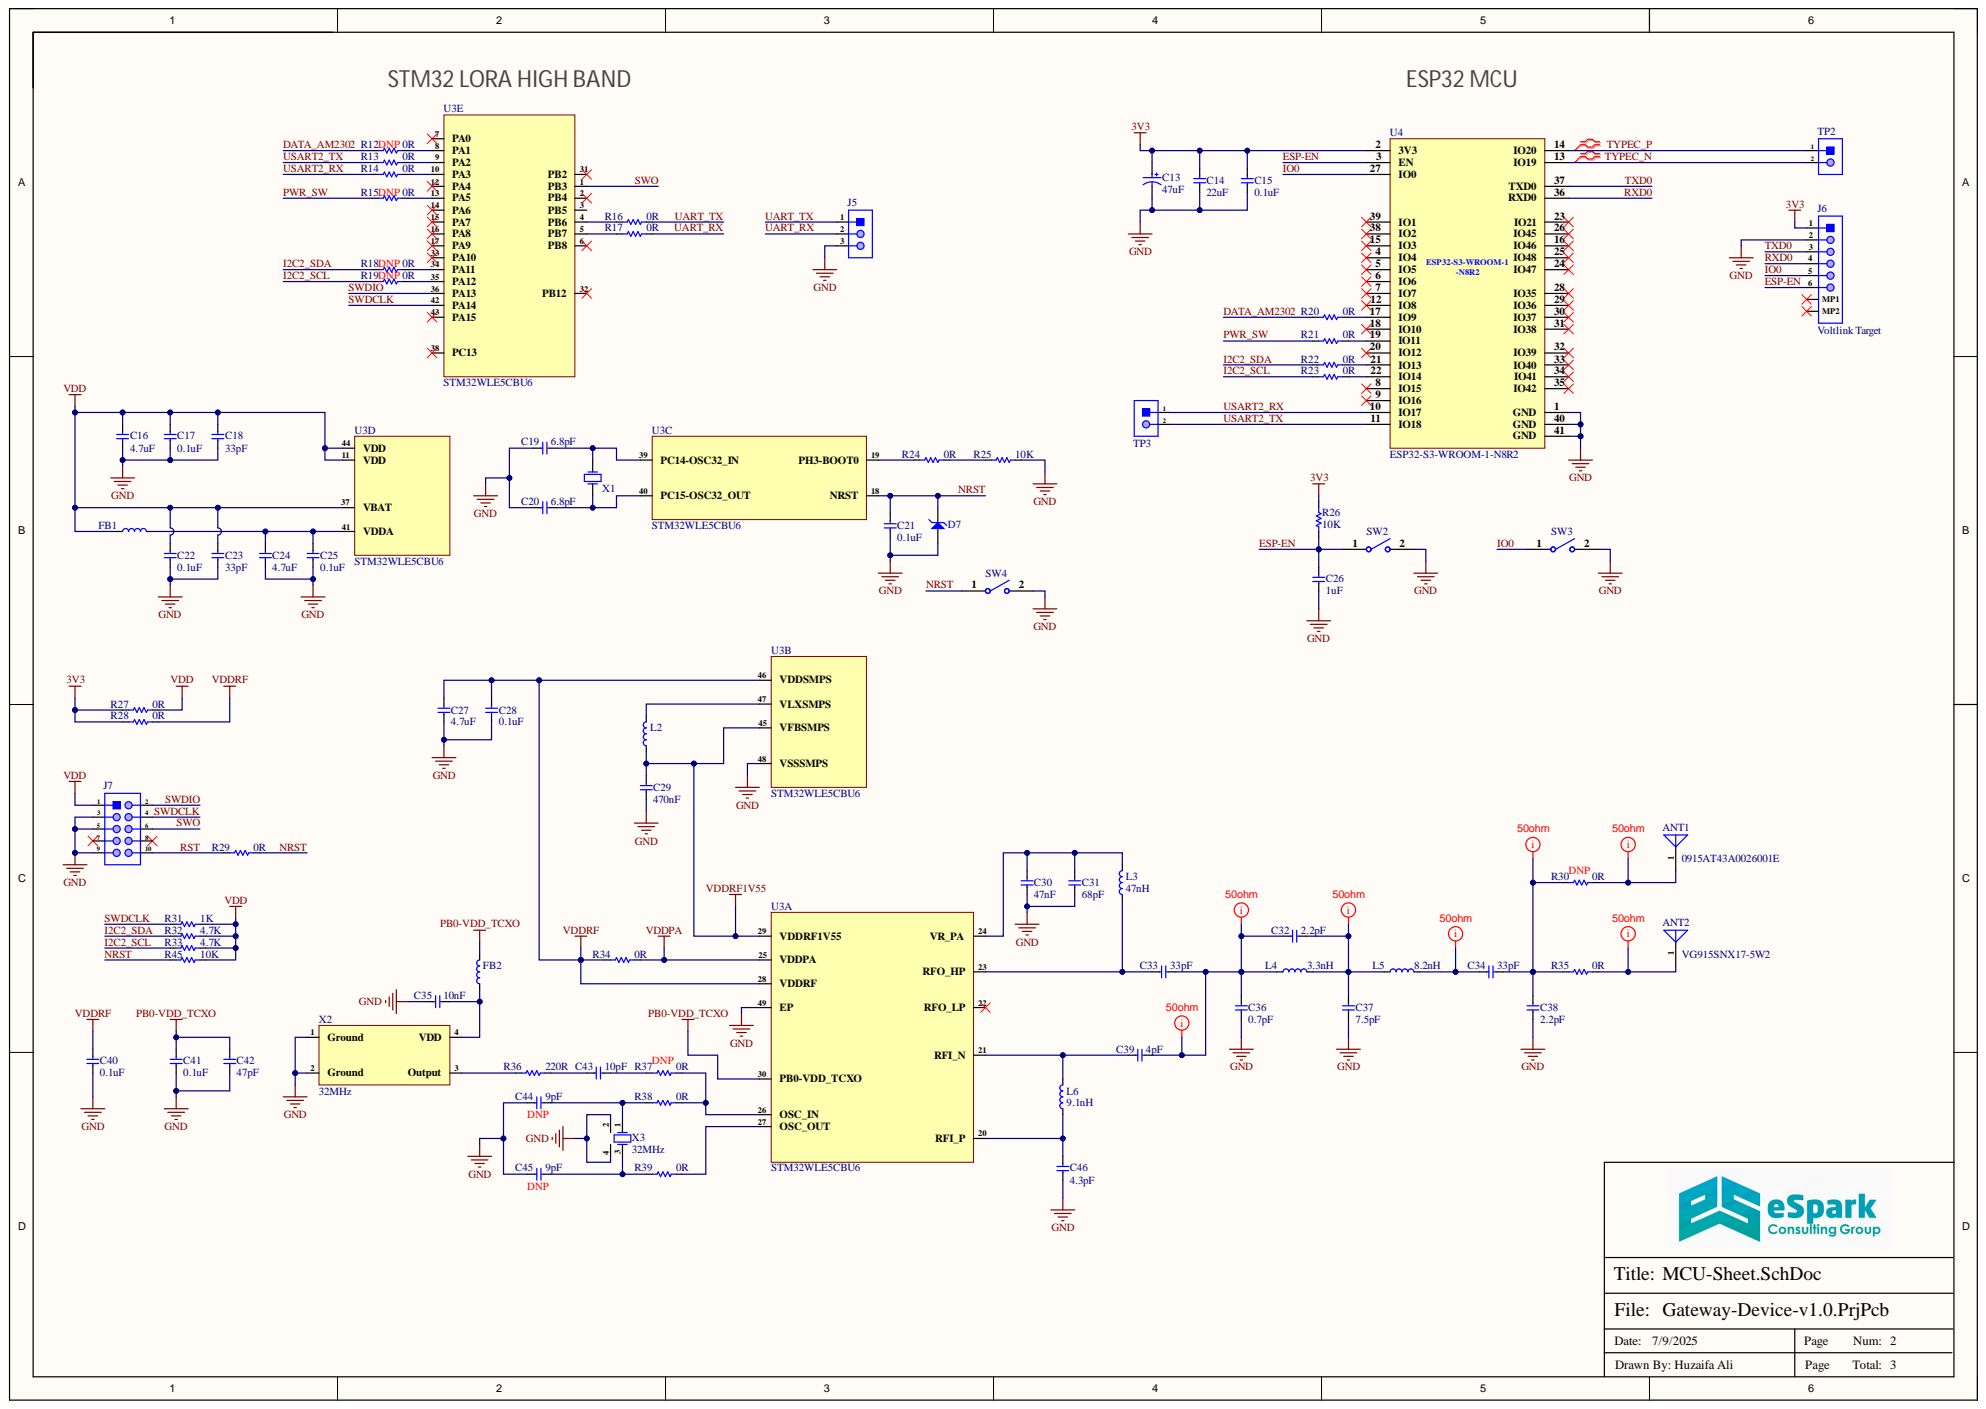
[picture p40: page 2]

Date: 7/9/2025 | Page Num: 2

Drawn By: Huzaifa Ali | Page Total: 3

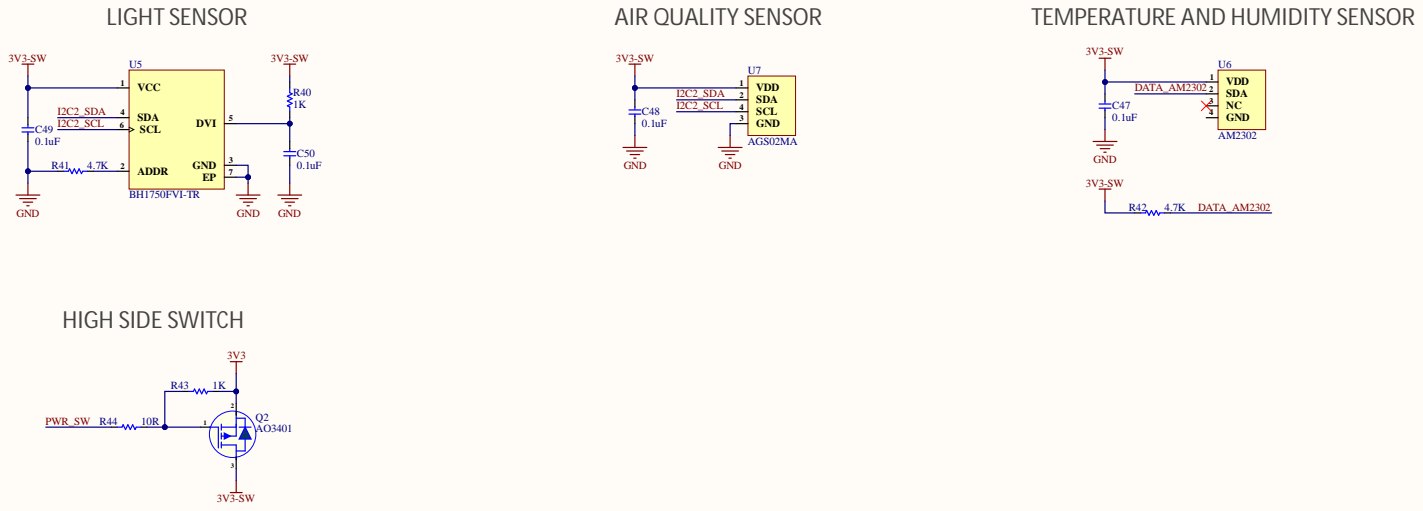
[picture p41: page 3]

Date : 7/8/2 0 2 5 | P a g e Nu m : 33

Drawn By: Hu z aifa Ali | P a g e T ota l :

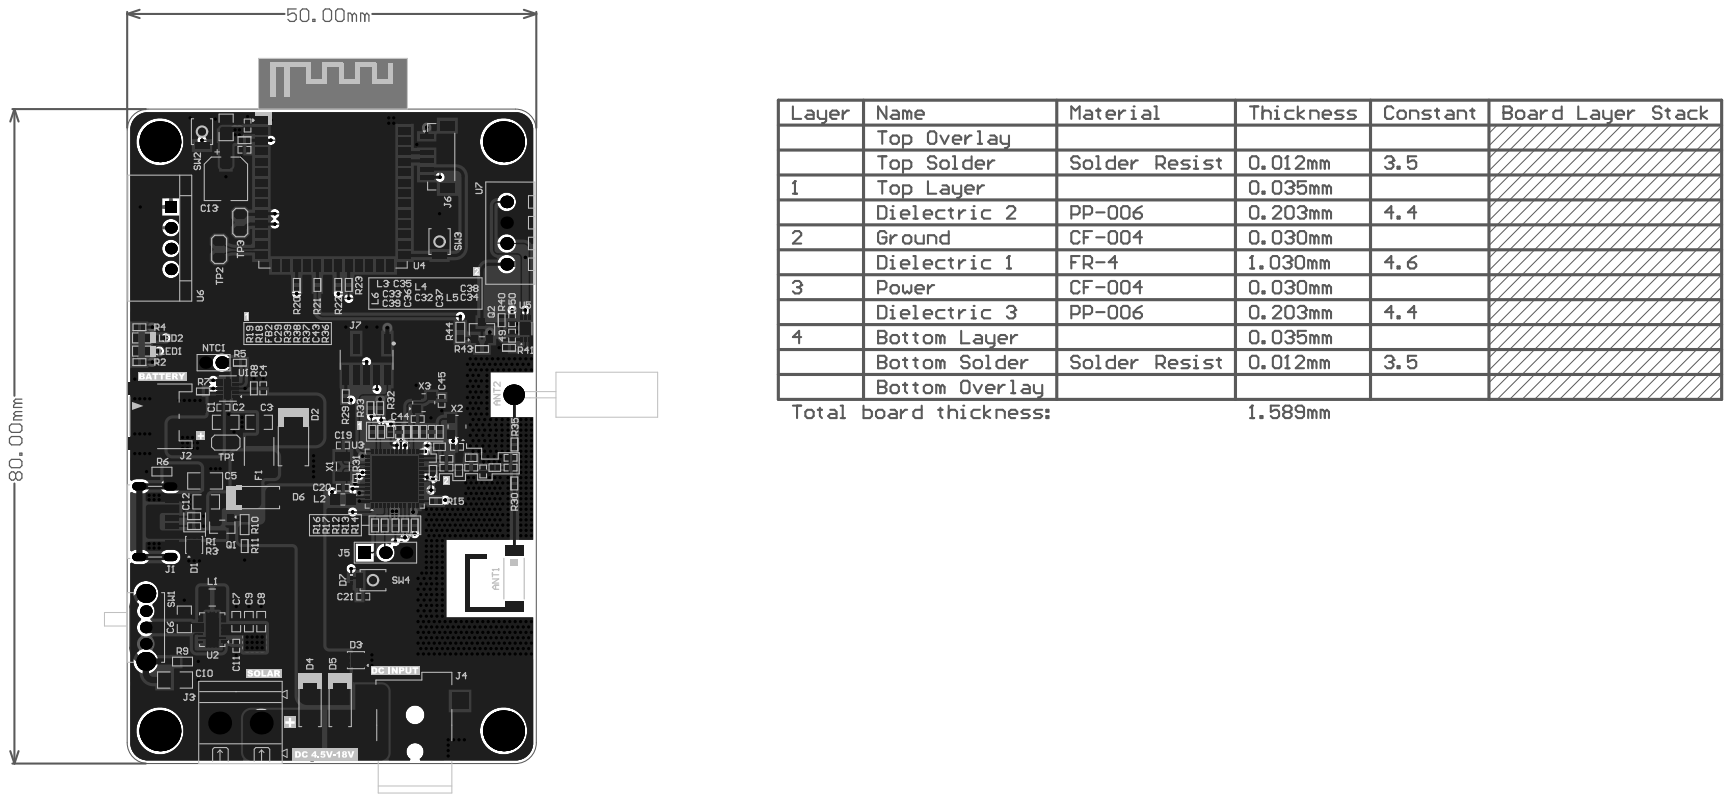
[picture p42: page 4]
