eSpark-Backup/awad-shibli-wireless-sensor-network/(list of files, drawings)

Other design files:
Design-Files/End-Device-v1.0/End-Device-v1.0.PcbDoc
Design-Files/End-Device-v1.0/End-Device-v1.0.PrjPcb
Design-Files/End-Device-v1.0/MCU-Sheet.SchDoc
Design-Files/End-Device-v1.0/Power-Sheet.SchDoc
Design-Files/End-Device-v1.0/Sensor-Sheet.SchDoc
Design-Files/Gateway-Device-v1.0/Gateway-Device-v1.0.PcbDoc
Design-Files/Gateway-Device-v1.0/Gateway-Device-v1.0.PrjPcb
Design-Files/Gateway-Device-v1.0/MCU-Sheet.SchDoc
Design-Files/Gateway-Device-v1.0/Power-Sheet.SchDoc
Design-Files/Gateway-Device-v1.0/Sensor-Sheet.SchDoc
docs/Client-Files/0060632C/0060631C.PcbDoc
docs/Client-Files/0060632C/0060631C.PrjPcb
docs/Client-Files/0060632C/0060631C_Library.SchLib
docs/Client-Files/WSN_Enviroment Monitoring System (11-20-2024 6-01-19 PM)/5V Boost Module.SchDoc
docs/Client-Files/WSN_Enviroment Monitoring System (11-20-2024 6-01-19 PM)/Solar Power Management.SchDoc
docs/Client-Files/WSN_Enviroment Monitoring System (11-20-2024 6-01-19 PM)/TOP LEVEL.SchDoc
docs/Client-Files/WSN_Enviroment Monitoring System (11-20-2024 6-01-19 PM)/TPL5110 Module.SchDoc
docs/Client-Files/WSN_Enviroment Monitoring System (11-20-2024 6-01-19 PM)/WSN_Enviroment Monitoring system.PcbDoc
docs/Client-Files/WSN_Enviroment Monitoring System (11-20-2024 6-01-19 PM)/WSN_Enviroment Monitoring system.PcbLib
docs/Client-Files/WSN_Enviroment Monitoring System (11-20-2024 6-01-19 PM)/WSN_Enviroment Monitoring System.PrjPcb
docs/Client-Files/WSN_Enviroment Monitoring System (11-20-2024 6-01-19 PM)/WSN_Enviroment Monitoring system.SchLib
