eSpark-Backup/awad-shibli-wireless-sensor-network/(commit log)

2025-06-26 gitignore and client files added.
    [0060631C.PcbDoc, 0060631C.PrjPcb, 0060631C.SCH, 0060631C_Library.SchLib, 0060632C.SCH, 0060633C.SCH, 5V Boost Module.SchDoc, Solar Power Management.SchDoc]
2025-07-02 #2 In Progress
    [End-Device-v1.0.PrjPcb, MCU-Sheet.SchDoc, Power-Sheet.SchDoc]
2025-07-04 #2 End Device in progress
    [End-Device-v1.0.PrjPcb, MCU-Sheet.SchDoc, Power-Sheet.SchDoc, Sensor-Sheet.SchDoc]
2025-07-07 #2 End Device Complete. PDF Generated
    [End-Device-v1.0.PrjPcb, MCU-Sheet.SchDoc, Power-Sheet.SchDoc, Sensor-Sheet.SchDoc]
2025-07-07 #2 Complete
    [MCU-Sheet.SchDoc, Power-Sheet.SchDoc, Sensor-Sheet.SchDoc]
2025-07-07 #2 #3 Complete. PDF Generated
    [Gateway-Device-v1.0.PrjPcb, MCU-Sheet.SchDoc, Power-Sheet.SchDoc, Sensor-Sheet.SchDoc]
2025-07-07 #3 Complete
    [Gateway-Device-v1.0.PrjPcb]
2025-07-07 #3 Test point added. PDF updated
    [MCU-Sheet.SchDoc, Power-Sheet.SchDoc, Sensor-Sheet.SchDoc]
2025-07-07 #2 #3
    [MCU-Sheet.SchDoc]
2025-07-09 #4 Placement Completed
    [Gateway-Device-v1.0.PcbDoc, Gateway-Device-v1.0.PrjPcb, MCU-Sheet.SchDoc]
2025-07-14 #4 PCB Design Completed
    [End-Device-v1.0.PcbDoc, End-Device-v1.0.PrjPcb, Gateway-Device-v1.0.PcbDoc, Gateway-Device-v1.0.PrjPcb, MCU-Sheet.SchDoc, Sensor-Sheet.SchDoc]
2025-07-15 #5 PCB Completed and Deliverables Generated
    [Centroid File.csv, Client BOM of End-Device-v1.0.xlsx, Client BOM of Gateway-Device-v1.0.xlsx, End-Device-v1.0..DXF, End-Device-v1.0.DWG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]
2025-07-15 Client BOM added both design.
    [Client BOM of End-Device-v1.0.xlsx, Client BOM of Gateway-Device-v1.0.xlsx]
2025-07-16 Client BOM Update.
    Battery Peripheral added.
    [Client BOM of End-Device-v1.0.xlsx, Client BOM of Gateway-Device-v1.0.xlsx]
